YunelySR/Yunely_Sanchez_Electiva_2025_C1/Tema 5 - Diseño PCB/Clase 10 - Yunely Sánchez Ruiz.pdf

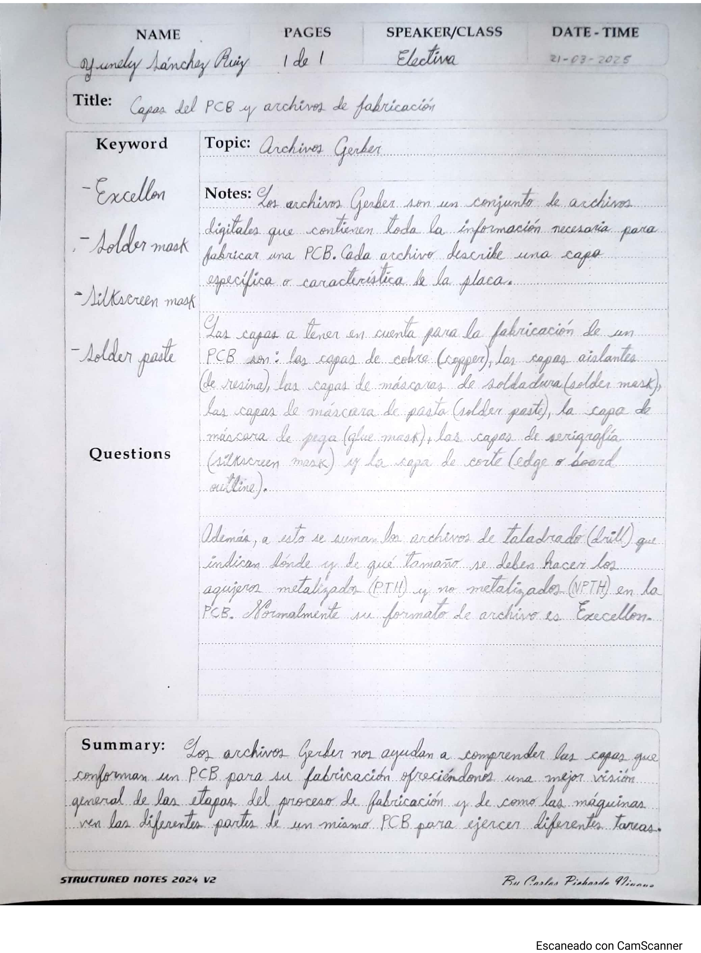
[picture p3: page 1]
