YunelySR/Yunely_Sanchez_Electiva_2025_C1/Tema 1 - Introducción al diseño mecatrónico/Clase 1.2 - Yunely Sánchez Ruiz.pdf

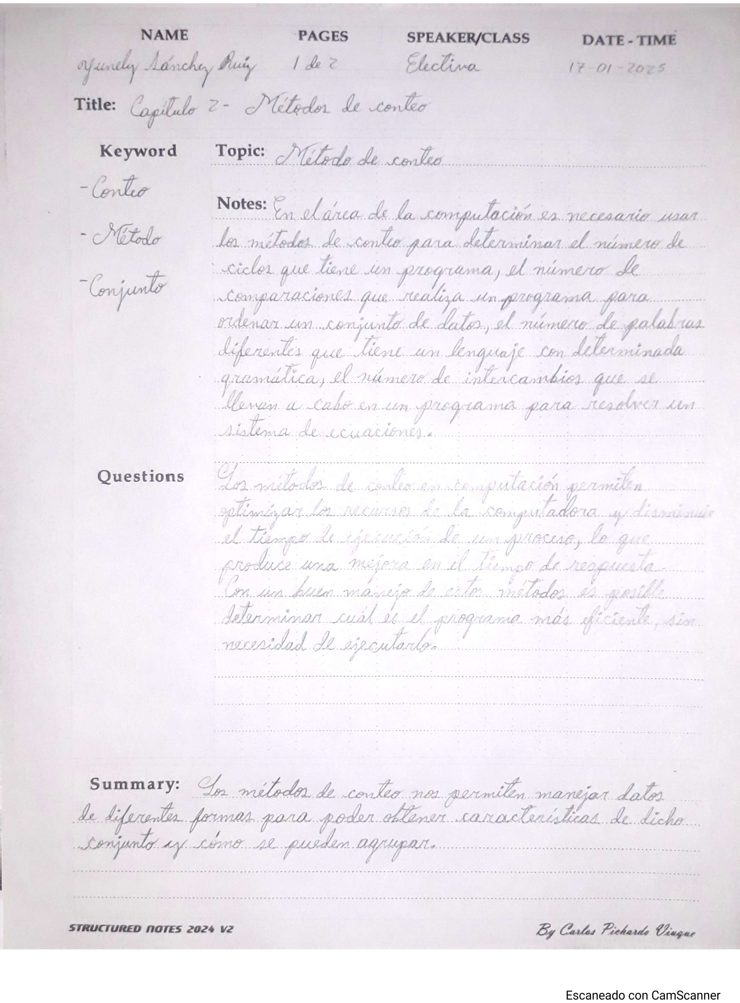
[picture p4: page 1]
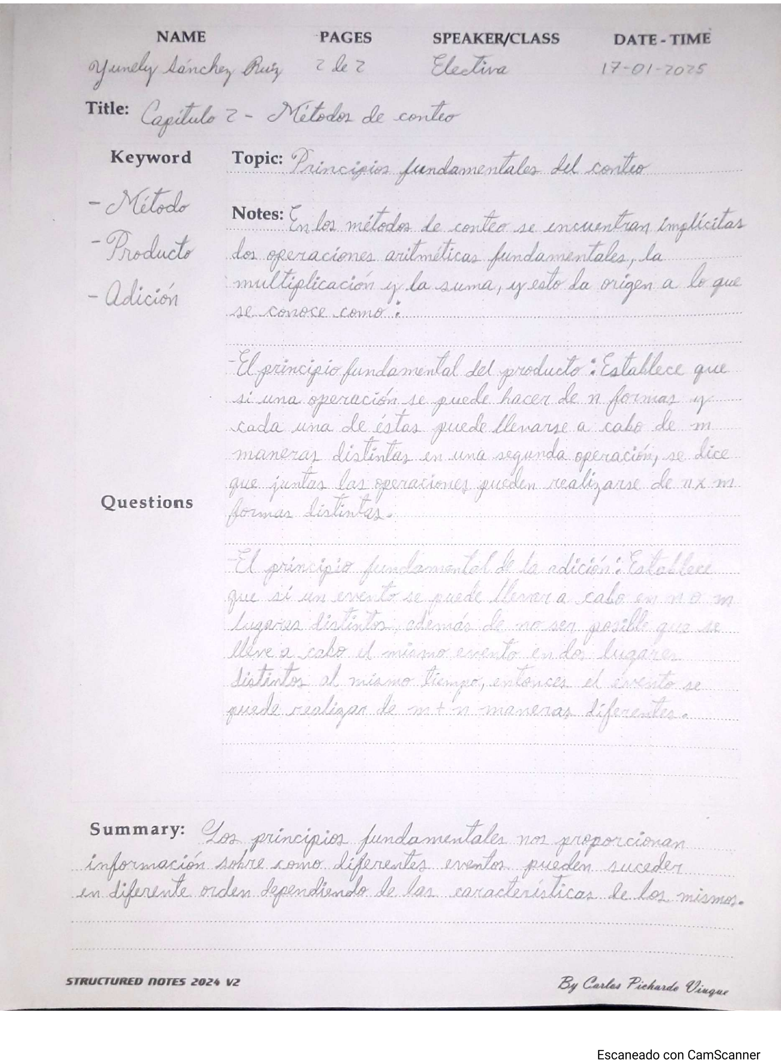
[picture p5: page 2]
