YunelySR/Yunely_Sanchez_Electiva_2025_C1/Tema 3 - Ingeniería de requisitos/Clase 5 - Yunely Sánchez Ruiz.pdf

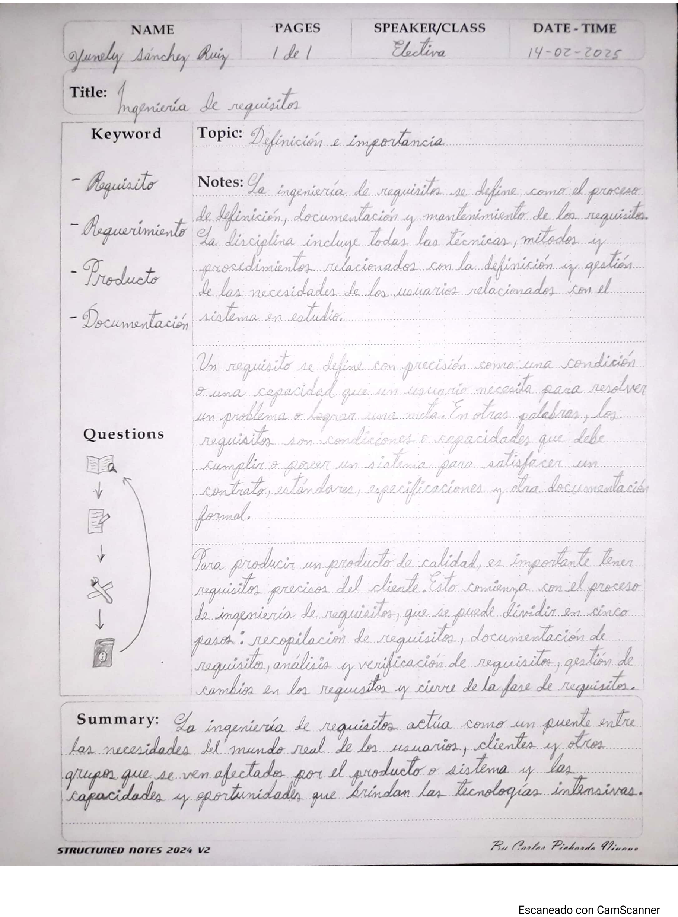
[picture p6: page 1]
