YunelySR/Yunely_Sanchez_Electiva_2025_C1/Librería de componentes.xlsx

Sheet: Resistencias
Número de parte | Valor (Ω) | Tolerancia (%) | Potencia (W) | Coeficiente de tempratura (PPM/°C) | Fabricante | Agregado
TNPW121010R0FEEA | 10 | 1 | 0.5 | 25 | Vishay | 1
TNPW1210100RFEEA | 100 | 1 | 0.5 | 25 | Vishay | 1
TNPW1206120RFEEA | 120 | 1 | 0.52 | 25 | Vishay | 1
TNPW1206220RFEEA | 220 | 1 | 0.52 | 25 | Vishay | 1
TNPW1206330RFEEA | 330 | 1 | 0.52 | 25 | Vishay | 1
TNPW1206470RFEEA | 470 | 1 | 0.52 | 25 | Vishay | 1
TNPW1206510RBEEA | 510 | 0.1 | 0.52 | 25 | Vishay | 1
TNPW1206560RFEEA | 560 | 1 | 0.52 | 25 | Vishay | 1
TNPW1206680RFEEA | 680 | 1 | 0.52 | 25 | Vishay | 1
TNPW1206820RBYEA | 820 | 0.1 | 0.52 | 10 | Vishay | 1
TNPW12101K00FEEA | 1k | 1 | 0.5 | 25 | Vishay | 1
PCAN0805E1001FST3 | 1k | 1 | 1 | 25 | Vishay | 1
TNPW12101K20BYEA | 1.2k | 0.1 | 0.5 | 10 | Vishay | 1
TNPW12102K20DEEA | 2.2k | 0.5 | 0.5 | 25 | Vishay | 1
TNPW12103K30BYEA | 3.3k | 0.1 | 0.5 | 10 | Vishay | 1
TNPW12104K70BEEA | 4.7k | 0.1 | 0.5 | 25 | Vishay | 1
TNPW12065K10BXEA | 5.1k | 0.1 | 0.52 | 15 | Vishay | 1
TNPW12065K60BEEA | 5.6k | 0.1 | 0.52 | 25 | Vishay | 1
TNPW12106K80BEEA | 6.8k | 0.1 | 0.5 | 25 | Vishay | 1
TNPW12068K20BEEA | 8.2k | 0.1 | 0.52 | 25 | Vishay | 1
TNPW121010K0DEEA | 10k | 0.5 | 0.5 | 25 | Vishay | 1
PHPA1206E1002BST1 | 10k | 0.1 | 1 | 25 | Vishay | 1
TNPW121012K0BEEA | 12k | 0.1 | 0.5 | 25 | Vishay | 1
TNPW120622K0BYEN | 22k | 0.1 | 0.52 | 10 | Vishay | 1
TNPW120633K0BYEN | 33k | 0.1 | 0.52 | 10 | Vishay | 1
MCA1206ME4702BP100 | 47k | 0.1 | 0.52 | 15 | Vishay | 1
TNPW120651K0DEEA | 51k | 0.1 | 0.52 | 25 | Vishay | 1
TNPW120656K0BEEA | 56k | 0.1 | 0.52 | 25 | Vishay | 1
TNPW120668K0BEEA | 68k | 0.1 | 0.52 | 25 | Vishay | 1
TNPW120682K0DEEA | 82k | 0.5 | 0.52 | 25 | Vishay | 1
TNPW1206100KBXEA | 100k | 0.1 | 0.52 | 15 | Vishay | 1
P-2512Y1003DSTS | 100k | 0.5 | 1 | 10 | Vishay | 1
TNPW1206120KBXEN | 120k | 0.1 | 0.52 | 15 | Vishay | 1
TNPW1206220KBEEA | 220k | 0.1 | 0.52 | 25 | Vishay | 1
TNPW1206330KDEEA | 330k | 0.5 | 0.52 | 25 | Vishay | 1
TNPW1206470KDEEA | 470k | 0.5 | 0.52 | 25 | Vishay | 1
TNPW1206510KDEEA | 510k | 0.5 | 0.52 | 25 | Vishay | 1
TNPW1206560KBEEA | 560k | 0.1 | 0.52 | 25 | Vishay | 1
TNPW1206680KBEEA | 680k | 0.1 | 0.52 | 25 | Vishay | 1
MCA1206MD8203DP500 | 820k | 0.5 | 0.52 | 25 | Vishay | 1
TNPW12101M00DEEA | 1M | 0.5 | 0.5 | 25 | Vishay | 1

Sheet: Capacitores
Número de parte | Valor (F) | Tolerancia (%) | Voltaje (v) | Tipo de voltaje | Vida útil (horas) | Tipo | Fabricante | Agregado
C0402C508B5GACAUTO | 0.5p | 20 | 50 | DC | - | Cerámico - Automtive MLCC | KEMET | 1
C0603C109B5GACAUTO | 1p | 10 | 50 | DC | - | Cerámico - Automtive MLCC | KEMET | 1
C0603C229B5GACAUTO | 2.2p | 5 | 50 | DC | - | Cerámico - Automtive MLCC | KEMET | 1
C0603C339B5GACAUTO | 3.3p | 3 | 50 | DC | - | Cerámico - Automtive MLCC | KEMET | 1
C0402C479B5GACAUTO | 4.7p | 2 | 50 | DC | - | Cerámico - Automtive MLCC | KEMET | 1
C0402C569B5GACAUTO | 5.6p | 2 | 50 | DC | - | Cerámico - Automtive MLCC | KEMET | 1
C0603C689B5GACAUTO | 6.8p | 2 | 50 | DC | - | Cerámico - Automtive MLCC | KEMET | 1
C0603C759C5GACAUTO | 7.5p | 3 | 50 | DC | - | Cerámico - Automtive MLCC | KEMET | 1
C0603C829C5GACAUTO | 8.2p | 3 | 50 | DC | - | Cerámico - Automtive MLCC | KEMET | 1
C0603C100F5GACAUTO | 10p | 1 | 50 | DC | - | Cerámico - Automtive MLCC | KEMET | 1
C0603C220F5GACAUTO | 22p | 1 | 50 | DC | - | Cerámico - Automtive MLCC | KEMET | 1
C0603C330F5GACAUTO | 33p | 1 | 50 | DC | - | Cerámico - Automtive MLCC | KEMET | 1
C0603C470F5GACAUTO | 47p | 1 | 50 | DC | - | Cerámico - Automtive MLCC | KEMET | 1
C0603C560F5GACAUTO | 56p | 1 | 50 | DC | - | Cerámico - Automtive MLCC | KEMET | 1
C0603C680F5GACAUTO | 68p | 1 | 50 | DC | - | Cerámico - Automtive MLCC | KEMET | 1
C0603C750J5GACAUTO | 75p | 5 | 50 | DC | - | Cerámico - Automtive MLCC | KEMET | 1
C0402C101G5GACAUTO | 100p | 2 | 50 | DC | - | Cerámico - Automtive MLCC | KEMET | 1
C0603C221F5GACAUTO | 220p | 1 | 50 | DC | - | Cerámico - Automtive MLCC | KEMET | 1
C0603C331F5GACAUTO | 330p | 1 | 50 | DC | - | Cerámico - Automtive MLCC | KEMET | 1
C0603C471F5GACAUTO | 470p | 1 | 50 | DC | - | Cerámico - Automtive MLCC | KEMET | 1
C0603C561J5GACAUTO | 560p | 5 | 50 | DC | - | Cerámico - Automtive MLCC | KEMET | 1
C0603C681F5GACAUTO | 680p | 1 | 50 | DC | - | Cerámico - Automtive MLCC | KEMET | 1
C0603C751J5GACAUTO | 750p | 5 | 50 | DC | - | Cerámico - Automtive MLCC | KEMET | 1
C0603C821F5GACAUTO | 820p | 1 | 50 | DC | - | Cerámico - Automtive MLCC | KEMET | 1
C0603C102F5GACAUTO | 1n | 1 | 50 | DC | - | Cerámico - Automtive MLCC | KEMET | 1
C0603C222F5GACAUTO | 2.2n | 1 | 50 | DC | - | Cerámico - Automtive MLCC | KEMET | 1
C0603C332F5GACAUTO | 3.3n | 1 | 50 | DC | - | Cerámico - Automtive MLCC | KEMET | 1
C0603C472F5GACAUTO | 4.7n | 1 | 50 | DC | - | Cerámico - Automtive MLCC | KEMET | 1
C0603C562J5GACAUTO | 5.6n | 5 | 50 | DC | - | Cerámico - Automtive MLCC | KEMET | 1
C0603C682J5GACAUTO | 6.8n | 5 | 50 | DC | - | Cerámico - Automtive MLCC | KEMET | 1
C0805C752J2GACAUTO | 7.5n | 5 | 200 | DC | - | Cerámico - Automtive MLCC | KEMET | 1
C0805C822J1GACAUTO | 8.2n | 5 | 100 | DC | - | Cerámico - Automtive MLCC | KEMET | 1
C0603C103J5RECAUTO | 10n | 5 | 50 | DC | - | Cerámico - Automtive MLCC | KEMET | 1
C0603C223J5RECAUTO | 22n | 5 | 50 | DC | - | Cerámico - Automtive MLCC | KEMET | 1
C0603C333J5RECAUTO | 33n | 5 | 50 | DC | - | Cerámico - Automtive MLCC | KEMET | 1
C0603C473J5RECAUTO | 47n | 5 | 50 | DC | - | Cerámico - Automtive MLCC | KEMET | 1
C1206C563G5GACAUTO | 56n | 2 | 50 | DC | - | Cerámico - Automtive MLCC | KEMET | 1
C0603C683J5RECAUTO | 68n | 5 | 50 | DC | - | Cerámico - Automtive MLCC | KEMET | 1
C1210C823J5GACAUTO | 82n | 5 | 50 | DC | - | Cerámico - Automtive MLCC | KEMET | 1
C0603C104J5RECAUTO | 100n | 5 | 50 | DC | - | Cerámico - Automtive MLCC | KEMET | 1
C0805C224J5RECAUTO | 220n | 5 | 50 | DC | - | Cerámico - Automtive MLCC | KEMET | 1
C0805C334J5RECAUTO | 330n | 5 | 50 | DC | - | Cerámico - Automtive MLCC | KEMET | 1
C0805C474J5RECAUTO | 470n | 5 | 50 | DC | - | Cerámico - Automtive MLCC | KEMET | 1
C0805C684J5RECAUTO | 680n | 5 | 50 | DC | - | Cerámico - Automtive MLCC | KEMET | 1
C0805X105J5RACAUTO | 1u | 5 | 50 | DC | - | Cerámico - Automtive MLCC | KEMET | 1
EXV105M050A9BAA | 1u | 20 | 50 | DC | 3000 | Electrolítico de aluminio | KEMET | 1
EXV225M050A9BAA | 2.2u | 20 | 50 | DC | 3000 | Electrolítico de aluminio | KEMET | 1
EXV335M050A9BAA | 3.3u | 20 | 50 | DC | 3000 | Electrolítico de aluminio | KEMET | 1
EXV475M050S9DAA | 4.7u | 20 | 50 | DC | 3000 | Electrolítico de aluminio | KEMET | 1
EDH685M050S9DAA | 6.8u | 20 | 50 | DC | 2000 | Electrolítico de aluminio | KEMET | 1
EXV106M050S9GAA | 10u | 20 | 50 | DC | 3000 | Electrolítico de aluminio | KEMET | 1
EXV226M050S9HAA | 22u | 20 | 50 | DC | 3000 | Electrolítico de aluminio | KEMET | 1
EXV336M050S9MAA | 33u | 20 | 50 | DC | 5000 | Electrolítico de aluminio | KEMET | 1
EXV476M050S9PAA | 47u | 20 | 50 | DC | 5000 | Electrolítico de aluminio | KEMET | 1
EXV686M050S9PAA | 68u | 20 | 50 | DC | 5000 | Electrolítico de aluminio | KEMET | 1
EXV107M050S9PAA | 100u | 20 | 50 | DC | 5000 | Electrolítico de aluminio | KEMET | 1
EXV227M050S9PAA | 220u | 20 | 50 | DC | 5000 | Electrolítico de aluminio | KEMET | 1
EXV337M050S9RAA | 330u | 20 | 50 | DC | 5000 | Electrolítico de aluminio | KEMET | 1
EDH477M063S9TAA | 470u | 20 | 63 | DC | 2000 | Electrolítico de aluminio | KEMET | 1
PES228MKP3750QE4 | 750u | 20 | 63 | DC | 6300 | Electrolítico de aluminio | KEMET | 1
EDH108M050S9TAA | 1m | 20 | 50 | DC | 2000 | Electrolítico de aluminio | KEMET | 1
PES227KKP4220ME4 | 2.2m | 20 | 40 | DC | 6300 | Electrolítico de aluminio | KEMET | 0.5
PEV227HKL4320ME4 | 3.2m | 20 | 25 | DC | 6300 | Electrolítico de aluminio | KEMET | 1
PES227HKP4460ME4 | 4.6m | 20 | 25 | DC | 6300 | Electrolítico de aluminio | KEMET | 0.5

Sheet: Bobinas
Número de parte | Valor (H) | Tolerancia (%) | Corriente (A) | Tipo | Fabricante | Agregado
MLG1005S1N0BTD25 | 1n | 10 | 1 | Inductor RF multicapa | TDK | 1
MHQ1005P2N2BTD25 | 2.2n | 5 | 1 | Inductor RF multicapa | TDK | 1
MHQ1005P3N3BTD25 | 3.3n | 3 | 900m | Inductor RF multicapa | TDK | 1
MHQ1005P4N7BTD25 | 4.7n | 2 | 800m | Inductor RF multicapa | TDK | 1
MHQ1005P5N6BTD25 | 5.6n | 2 | 800m | Inductor RF multicapa | TDK | 1
MHQ1005P6N8GTD25 | 6.8n | 2 | 700m | Inductor RF multicapa | TDK | 1
MHQ1005P7N5GTD25 | 7.5n | 2 | 600m | Inductor RF multicapa | TDK | 1
MHQ1005P8N2GTD25 | 8.2 | 2 | 550m | Inductor RF multicapa | TDK | 1
MHQ1005P10NGTD25 | 10n | 2 | 500m | Inductor RF multicapa | TDK | 1
MLG1005S22NHTD25 | 22n | 3 | 350m | Inductor RF multicapa | TDK | 1
MLG1005S33NHTD25 | 33n | 3 | 300m | Inductor RF multicapa | TDK | 1
MLF2012D47NMTD25 | 47n | 20 | 300m | Inductor RF multicapa | TDK | 1
MLG1005S56NHTD25 | 56n | 3 | 200m | Inductor RF multicapa | TDK | 1
MLF2012D68NMTD25 | 68n | 20 | 300m | Inductor RF multicapa | TDK | 1
MLG1005S75NHTD25 | 75n | 3 | 200m | Inductor RF multicapa | TDK | 1
MLF2012D82NMTD25 | 82n | 20 | 300m | Inductor RF multicapa | TDK | 1
MLF2012DR10JTD25 | 100n | 5 | 300m | Inductor RF multicapa | TDK | 1
MLF2012DR22JTD25 | 220n | 5 | 250m | Inductor RF multicapa | TDK | 1
MLF2012DR33JTD25 | 330n | 5 | 250m | Inductor RF multicapa | TDK | 1
MLF2012DR47JTD25 | 470n | 5 | 200m | Inductor RF multicapa | TDK | 1
MLJ1608WGCR56NTD25 | 560n | 30 | 500m | Inductor RF multicapa | TDK | 1
MLF2012DR68JTD25 | 680n | 5 | 150m | Inductor RF multicapa | TDK | 1
MLF2012DR82JTD25 | 820n | 5 | 150m | Inductor RF multicapa | TDK | 1
KLZ2012AHR1R0WTD25 | 1u | 20 | 800m | Inductor RF multicapa | TDK | 1
SPM4030T-1R0M-HZ | 1u | 20 | 8 | Inductor de potencia | TDK | 1
KLZ2012AHR2R2WTD25 | 2.2u | 20 | 600m | Inductor RF multicapa | TDK | 1
SPM6530T-2R2M-HZ | 2.2u | 20 | 8.4 | Inductor de potencia | TDK | 1
KLZ2012MHR3R3HTD25 | 3.3u | 20 | 500m | Inductor RF multicapa | TDK | 1
SPM7054VT-3R3M-D | 3.3u | 20 | 9.5 | Inductor de potencia | TDK | 1
KLZ2012MHR4R7HTD25 | 4.7u | 20 | 400m | Inductor RF multicapa | TDK | 1
SPM6550T-4R7M-HZ | 4.7u | 20 | 8.2 | Inductor de potencia | TDK | 1
MLF1608E5R6JTD25 | 5.6u | 5 | 15m | Inductor RF multicapa | TDK | 1
SLF12575T-5R6N6R3-H | 5.6u | 30 | 6.3 | Inductor de potencia | TDK | 1
MLF1608E6R8JTD25 | 6.8u | 5 | 15m | Inductor RF multicapa | TDK | 1
SPM7054VT-6R8M-D | 6.8 | 20 | 6.8 | Inductor de potencia | TDK | 1
MLF1608E8R2JTD25 | 8.2u | 5 | 10m | Inductor RF multicapa | TDK | 1
B82442T1822K000 | 8.2u | 10 | 1.51 | Inductor de potencia | TDK | 1
KLZ2012MHR100HTD25 | 10u | 20 | 300m | Inductor RF multicapa | TDK | 1
SPM12565VT-100M-D | 10u | 20 | 9 | Inductor de potencia | TDK | 1
KLZ2012PHR220WTD25 | 22u | 20 | 220m | Inductor RF multicapa | TDK | 1
SPM12565VT-220M-D | 22u | 20 | 6.9 | Inductor de potencia | TDK | 1
MLF2012C330KTD25 | 33u | 10 | 5m | Inductor RF multicapa | TDK | 1
SPM10065VT-330M-D | 33u | 20 | 4.9 | Inductor de potencia | TDK | 1
KLZ2012MHR470WTD25 | 47u | 20 | 170m | Inductor RF multicapa | TDK | 1
SPM10065VT-470M-D | 47u | 20 | 4 | Inductor de potencia | TDK | 1
MLF2012K560KTD25 | 56u | 10 | 4m | Inductor RF multicapa | TDK | 1
B82442T1563K000 | 56u | 10 | 600m | Inductor de potencia | TDK | 1
MLF2012C680KTD25 | 68u | 10 | 2m | Inductor RF multicapa | TDK | 1
SPM10065VT-680M-D | 68u | 20 | 3.4 | Inductor de potencia | TDK | 1
MLF2012C820KTD25 | 82u | 10 | 2m | Inductor RF multicapa | TDK | 1
B82442T1823K000 | 82u | 10 | 540m | Inductor de potencia | TDK | 1
KLZ2012NHR101LTD25 | 100u | 20 | 140m | Inductor RF multicapa | TDK | 1
SPM7054VT-101M-D | 100u | 20 | 1.8 | Inductor de potencia | TDK | 1
CLF7045NIT-221M-D | 220u | 20 | 710m | Inductor de potencia | TDK | 1
CLF7045NIT-331M-D | 330u | 20 | 600m | Inductor de potencia | TDK | 1
CLF7045NIT-471M-D | 470u | 20 | 500m | Inductor de potencia | TDK | 1
B82442T1564K000 | 560u | 10 | 220m | Inductor de potencia | TDK | 1
B82464G4684M000 | 680u | 20 | 420m | Inductor de potencia | TDK | 1
B82442T1824K000 | 820u | 10 | 170m | Inductor de potencia | TDK | 1
B82464G4105M000 | 1m | 20 | 340m | Inductor de potencia | TDK | 1
B82442T1225K000 | 2.2m | 10 | 100m | Inductor de potencia | TDK | 1
B82442T1335K000 | 3.3m | 10 | 85m | Inductor de potencia | TDK | 1
B82442T1475K000 | 4.7m | 10 | 73m | Inductor de potencia | TDK | 1
B82442T1565K000 | 5.6m | 10 | 66m | Inductor de potencia | TDK | 1
B82442T1685K000 | 6.8m | 10 | 65m | Inductor de potencia | TDK | 1
B82442T1825K000 | 8.2m | 10 | 54m | Inductor de potencia | TDK | 1
B82442T1106K000 | 10m | 10 | 46m | Inductor de potencia | TDK | 1

Sheet: Transistores
Número de parte | Tecnología | Polaridad | Vgs-th (v) | Id (A) | Potencia (W) | Fabricante | Agregado
NVR5198NLT1G | MOSFET | Canal N | 1.5 | 2.2 | 1.5 | ONSEMI | 1
SVD5867NLT4G | MOSFET | Canal N | 1.5 | 22 | 43 | ONSEMI | 1
NVD5805NT4G-VF01 | MOSFET | Canal N | 1.5 | 51 | 47 | ONSEMI | 1
NCV8406BDTRKG | MOSFET | Canal N | 2 | 7 | 1.31 | ONSEMI | 1
NVMFS6H864NLT1G | MOSFET | Canal N | 2 | 22 | 33 | ONSEMI | 1
FDWS86368-F085 | MOSFET | Canal N | 2 | 80 | 214 | ONSEMI | 1
NVR5198NLT3G | MOSFET | Canal N | 2.5 | 2.2 | 1.5 | ONSEMI | 1
NVMFS5C468NT1G | MOSFET | Canal N | 2.5 | 35 | 28 | ONSEMI | 1
NVMFS5C456NWFT1G | MOSFET | Canal N | 2.5 | 80 | 55 | ONSEMI | 1
NVB082N65S3F | MOSFET | Canal N | 3 | 40 | 313 | ONSEMI | 1
NVTFS010N10MCLTAG | MOSFET | Canal N | 3 | 57.8 | 3.2 | ONSEMI | 1
NVMFS3D6N10MCLT1G | MOSFET | Canal N | 3 | 132 | 139 | ONSEMI | 1
NVMYS011N04CTWG | MOSFET | Canal N | 3.5 | 35 | 28 | ONSEMI | 1
NVMYS8D0N04CTWG | MOSFET | Canal N | 3.5 | 49 | 38 | ONSEMI | 1
NVMFS5C456NT1G | MOSFET | Canal N | 3.5 | 80 | 55 | ONSEMI | 1
NVTFS6H854NLTAG | MOSFET | Canal N | 4 | 44 | 68 | ONSEMI | 1
NVMFS6H836NLT1G | MOSFET | Canal N | 4 | 74 | 89 | ONSEMI | 1
NVMFS5C628NWFT1G | MOSFET | Canal N | 4 | 150 | 110 | ONSEMI | 1

Sheet: OPAMPs
Número de parte | Número de canales | GBP (Hz) | SR (V/us) | Vos (v) | Ib (A) | CMRR (dB) | Vdd Min (v) | Shutdown | Fabricante | Agregado
LTC2066HS5#TRMPBF | 1 | 100k | 17.5m | 1u | 5p | 134 | 1.7 | Sí | Analog Devices | 1
MAX4091AUK+T | 1 | 500k | 200m | 1.4m | 180n | 71 | 2.7 | No | Analog Devices | 1
AD548JRZ | 1 | 1M | 1.8 | 750u | 10p | 90 | 9 | No | Analog Devices | 1
AD8565AKSZ-REEL7 | 1 | 5M | 6 | 2m | 80n | 95 | 4.5 | No | Analog Devices | 1
MAX40075AUT/V+T | 1 | 10M | 10 | 30u | 1p | 109 | 2.7 | Sí | Analog Devices | 1
AD8031ARZ-REEL | 1 | 50M | 32 | 1m | 2u | 90 | 2.7 | No | Analog Devices | 1
MAX4105EUK+T | 1 | 100M | 1.4k | 1m | 70u | 80 | 7 | No | Analog Devices | 1
OP281GSZ | 2 | 105k | 27m | 1.5m | 10n | 65 | 2.7 | No | Analog Devices | 1
MAX4402AKA/V+T | 2 | 800k | 1 | 1m | 100f | 84 | 2.5 | No | Analog Devices | 1
AD648KRZ | 2 | 1M | 1.8 | 750u | 15p | 76 | 9 | No | Analog Devices | 1
AD8566ARMZ-REEL | 2 | 5M | 6 | 2m | 80n | 95 | 4.5 | No | Analog Devices | 1
MAX40077AUA+T | 2 | 10M | 10 | 30u | 260p | 90 | 2.7 | Sí | Analog Devices | 1
AD8032ARZ-REEL7 | 2 | 50M | 32 | 1m | 12u | 90 | 2.7 | No | Analog Devices | 1
AD8062ARZ-R7 | 2 | 90M | 650 | 1m | 9u | 80 | 2.7 | No | Analog Devices | 1
ADA4891-3ARZ | 3 | 105M | 170 | 2.5m | 50p | 88 | 2.7 | No | Analog Devices | 1
ADA4891-3ARZ-R7 | 3 | 105M | 210 | 2..5m | 50p | 88 | 2.7 | No | Analog Devices | 1
OP481GSZ | 4 | 105k | 28m | 100u | 10n | 65 | 2.7 | No | Analog Devices | 1
OP496GSZ | 4 | 450k | 300m | 300u | 50n | 65 | 3 | No | Analog Devices | 1
AD8544WARZ-R7 | 4 | 1M | 920m | 1m | 60p | 45 | 2.7 | No | Analog Devices | 1
AD8567ARUZ | 4 | 5M | 6 | 2m | 80n | 95 | 4.5 | No | Analog Devices | 1
MAX40078AUD+ | 4 | 10M | 10 | 30u | 260p | 90 | 2.7 | Sí | Analog Devices | 1
AD8040ARUZ | 4 | 45M | 62 | 1.6m | 1.3u | 80 | 2.7 | No | Analog Devices | 1
ADA4891-4ARZ | 4 | 105M | 170 | 2.5m | 50p | 88 | 2.7 | No | Analog Devices | 1

Sheet: LEDs
Número de parte | Tipo | Color | If (A) | Vf (v) | Fabricante | Agregado
LS L29K-G1J2-1 | Unicolor | Rojo | 2m | 2.2 | ams OSRAM | 1
KB DELPS2.DI-QGRI-2J8L-U515 | Unicolor | Azul | 2m | 2.7 | ams OSRAM | 1
LG T67K-H2K2-24 | Unicolor | Verde | 2m | 1.9 | ams OSRAM | 0.5
LY T67K-J2M1-26 | Unicolor | Amarillo | 20m | 2.2 | ams OSRAM | 0.5
KW DELPS2.RA-QISI-FK2NM2-U515 | Unicolor | Blanco | 2m | 2.7 | ams OSRAM | 1
LA M676-K1M1-24-Z | Unicolor | Ámbar | 2m | 1.8 | ams OSRAM | 0.5
LO M67K-L1M2-24-0-2-R18-Z | Unicolor | Naranja | 2m | 1.8 | ams OSRAM | 0.5
LSG T67K-JL-1+HK-1 | Bicolor | Rojo-Verde | 2m | 1.8 | ams OSRAM | 1
LSY T676-P2R1-1-0+Q2S1-35 | Bicolor | Rojo-Amarillo | 30m | 2.4 | ams OSRAM | 1
LYG T67K-JL-1+HK-1 | Bicolor | Amarillo-Verde | 2m | 1.9 | ams OSRAM | 1
SFH 7018A | Tricolor | Rojo-Verde-Infrarojo | 250m | 2.7 | ams OSRAM | 1
KRTBLSLPS1.32-VUVY-EQ+BTBV-D8+TXUV-L1-B | Multicolor | RGB | 20m | 2.8 | ams OSRAM | 0.5
LTRBR37G-4R4S-0125-0 | RGB | RGB | 2m | 2.8 | ams OSRAM | 1
LRTB R48G | RGB | RGB | 10m | 2.7 | ams OSRAM | 1
KRTBLFLM71.32-TZUV-GQ+VTVX-FM+RYSX-QW-LB | RGB | RGB | 15m | 3 | ams OSRAM | 0.5
LRTBR98G-R5T-1+S7T7-35+PQ-25 | RGB | RGB | 20m | 3.2 | ams OSRAM | 1
SFH 4243-Q1R2 | IR | IR | 70m | 1.6 | ams OSRAM | 1
SFH 4249-UV | IR | IR | 100m | 1.5 | ams OSRAM | 1

Sheet: Varistores
Número de parte | Régimen de voltaje DC (v) | Régimen de voltaje AC (v) | Voltaje nominal (v) | Voltaje de clamping (v) | Fabricante | Agregado
V8ZA2P | 5 | 4 | 6 | 20 | Littelfuse | 1
V9MLA0603NH | 9 | 6.5 | 11 | 25.5 | Littelfuse | 1
V12MLA0805LNHAUTO | 12 | 9 | 14 | 29 | Littelfuse | 1
V22MA1A | 15 | 10 | 22 | 55 | Littelfuse | 0.5
V24AUMLA2220H | 24 | - | 39 | 60 | Littelfuse | 1
V27MA1A | 19 | 13 | 21 | 67 | Littelfuse | 0.5
V39ZA1P | 31 | 25 | 35 | 79 | Littelfuse | 0.5
V100ZA15P | 81 | 60 | 90 | 175 | Littelfuse | 0.5
V130LA20BP | 175 | 130 | 190 | 325 | Littelfuse | 0.5
V430MA3A | 349 | 253 | 365 | 740 | Littelfuse | 0.5
V20E385P | 505 | 385 | 558 | 1025 | Littelfuse | 1
V20E440P | 585 | 440 | 643 | 1180 | Littelfuse | 0.5

Sheet: Diodos TVS
Número de parte | Número de canales | Voltaje de funcionamiento inverso (v) | Voltaje de clamping (v) | Polaridad | Fabricante | Agregado
SMF3.3 | 1 | 3.3 | 6.8 | Unidireccional | Littelfuse | 1
SP3031-01ETG | 1 | 5 | 7.5 | Unidireccional | Littelfuse | 1
SMF4L9.0A | 1 | 9 | 15.4 | Unidireccional | Littelfuse | 1
SACB10 | 1 | 10 | 16.3 | Unidireccional | Littelfuse | 1
TPSMB12A-VR | 1 | 12 | 19.9 | Unidireccional | Littelfuse | 1
SPHV15-01ETG | 1 | 15 | 22 | Unidireccional | Littelfuse | 0.5
SMA6J24A | 1 | 24 | 38.9 | Unidireccional | Littelfuse | 1
SP3401-02UTG | 2 | 3.3 | 9 | Unidireccional | Littelfuse | 1
SM05-02HTG | 2 | 5 | 13 | Unidireccional | Littelfuse | 1
SP4010-02HTG | 2 | 10 | 43 | Unidireccional | Littelfuse | 0.5
SM12-02HTG | 2 | 12 | 22.5 | Unidireccional | Littelfuse | 1
SM15-02HTG | 2 | 15 | 30 | Unidireccional | Littelfuse | 1
SM24-02HTG | 2 | 24 | 42 | Unidireccional | Littelfuse | 0.5
SP3420-04UTG | 4 | 3.3 | 6 | Unidireccional | Littelfuse | 1
SP3019-04HTG | 4 | 5 | 11.5 | Unidireccional | Littelfuse | 1
SP4065-08ATG | 8 | 3.3 | 13.5 | Unidireccional | Littelfuse | 1
SP7538PUTG | 8 | 5 | 7 | Unidireccional | Littelfuse | 0.5
SC1533-01FTG | 1 | 3.3 | 6.8 | Bidireccional | Littelfuse | 1
SP4337-01WTG | 1 | 5 | 7 | Bidireccional | Littelfuse | 1
SESD0201X1BN-0010-098 | 1 | 9 | 10 | Bidireccional | Littelfuse | 1
TPSMB12CA-VR | 1 | 12 | 19.9 | Bidireccional | Littelfuse | 1
PGB2010201KR-15NR | 1 | 15 | 20 | Bidireccional | Littelfuse | 1
SP4338-02WTG | 2 | 5 | 6 | Bidireccional | Littelfuse | 1
SP712-02HTG | 2 | 12 | 20 | Bidireccional | Littelfuse | 1
AQ15-02HTG | 2 | 15 | 30 | Bidireccional | Littelfuse | 1
AQ24-02HTG | 2 | 24 | 42 | Bidireccional | Littelfuse | 0.5
SP1015-04WTG | 4 | 5 | 12 | Bidireccional | Littelfuse | 1
SP1012-05WTG | 5 | 5 | 12.3 | Bidireccional | Littelfuse | 1

Sheet: No clasificados
SSSF021500 | Switch
B3SL-1022P | Botón
12401832E402A | Conector USB
WJ128V-5.0-6P | Screw terminal block
3296W-1-203LF | Potenciómetro
RLB1014-104KL | Bobina de poder
RVT1H470M0607 | Capacitor bulk
XT30UPB-M | Conector XT30
