YunelySR/Yunely_Sanchez_Electiva_2025_C1/Tema 2 - Selección de componentes/Clase 2 - Yunely Sánchez Ruiz.pdf

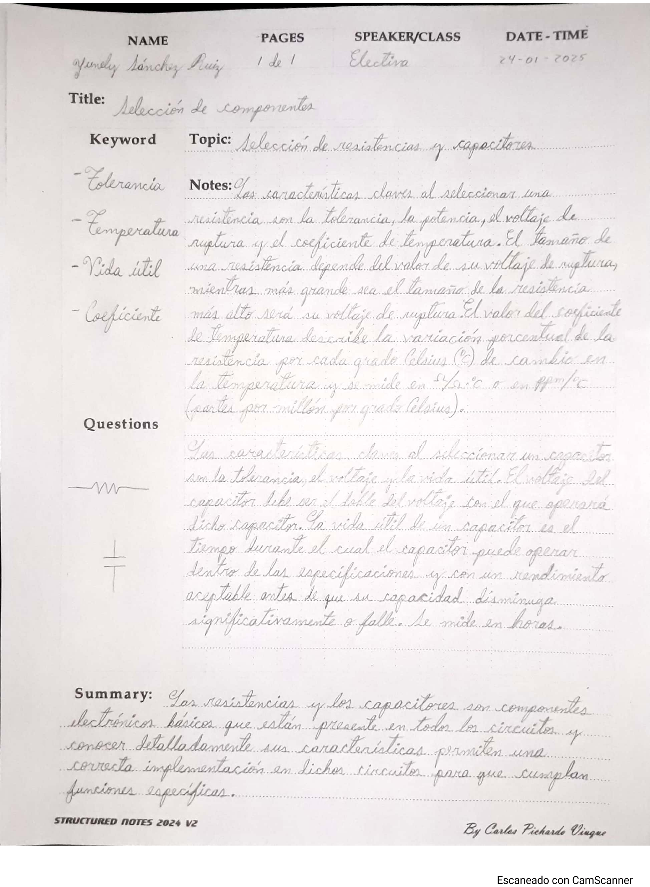
[picture p9: page 1]
