YunelySR/Yunely_Sanchez_Electiva_2025_C1/Tema 2 - Selección de componentes/Clase 3 - Yunely Sánchez Ruiz.pdf

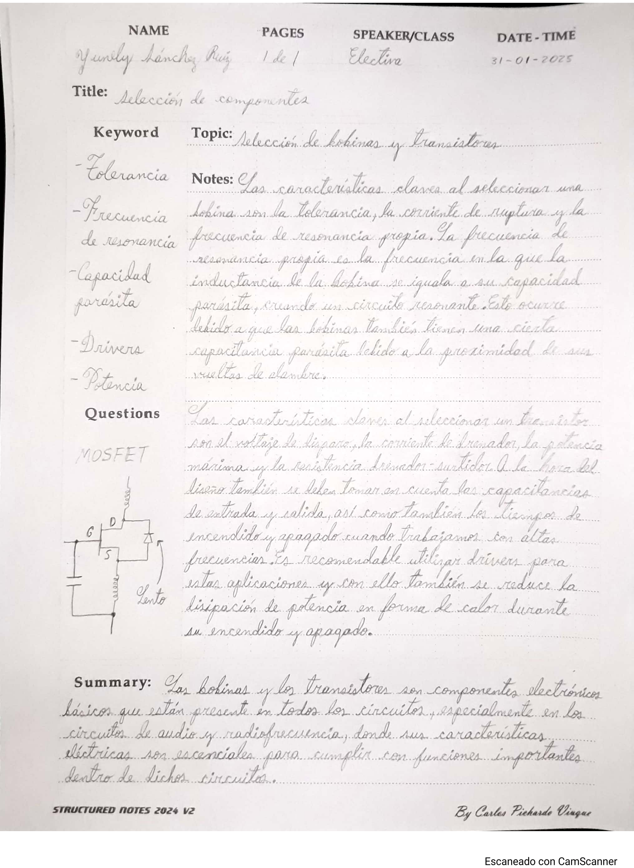
[picture p10: page 1]
