YunelySR/Yunely_Sanchez_Electiva_2025_C1/Tema 6 - Diseño mecánico/Tarea_3_Diseño_de_la_carcasa/Diseño en FreeCAD/Parte inferior.FCStd

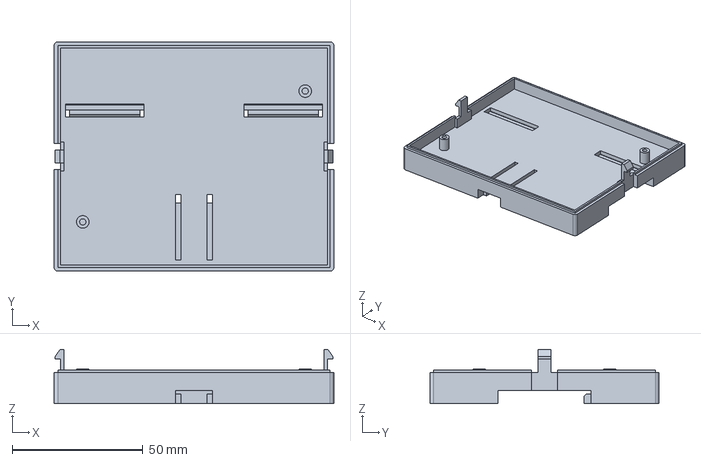
[picture p12: CAD file, 2025-04-21]
Tema 6 - Diseño mecánico/Tarea_3_Diseño_de_la_carcasa/Diseño en FreeCAD/Parte inferior.FCStd
107.0 x 87.7 x 20.8 mm
