YunelySR/Yunely_Sanchez_Electiva_2025_C1/(list of files, cad)

Other CAD files:
Tema 6 - Diseño mecánico/Tarea_3_Diseño_de_la_carcasa/Diseño en FreeCAD/Ensamble.FCStd
