YunelySR/Yunely_Sanchez_Electiva_2025_C1/Tema 4 - De requisitos a diseño mecatrónico/Tarea_2_Aislador_USB/Tarea_2_Aislador_USB.kicad_pcb

## KiCad design Tema 4 - De requisitos a diseño mecatrónico/Tarea_2_Aislador_USB/Tarea_2_Aislador_USB.kicad_pcb (2025-03-21)

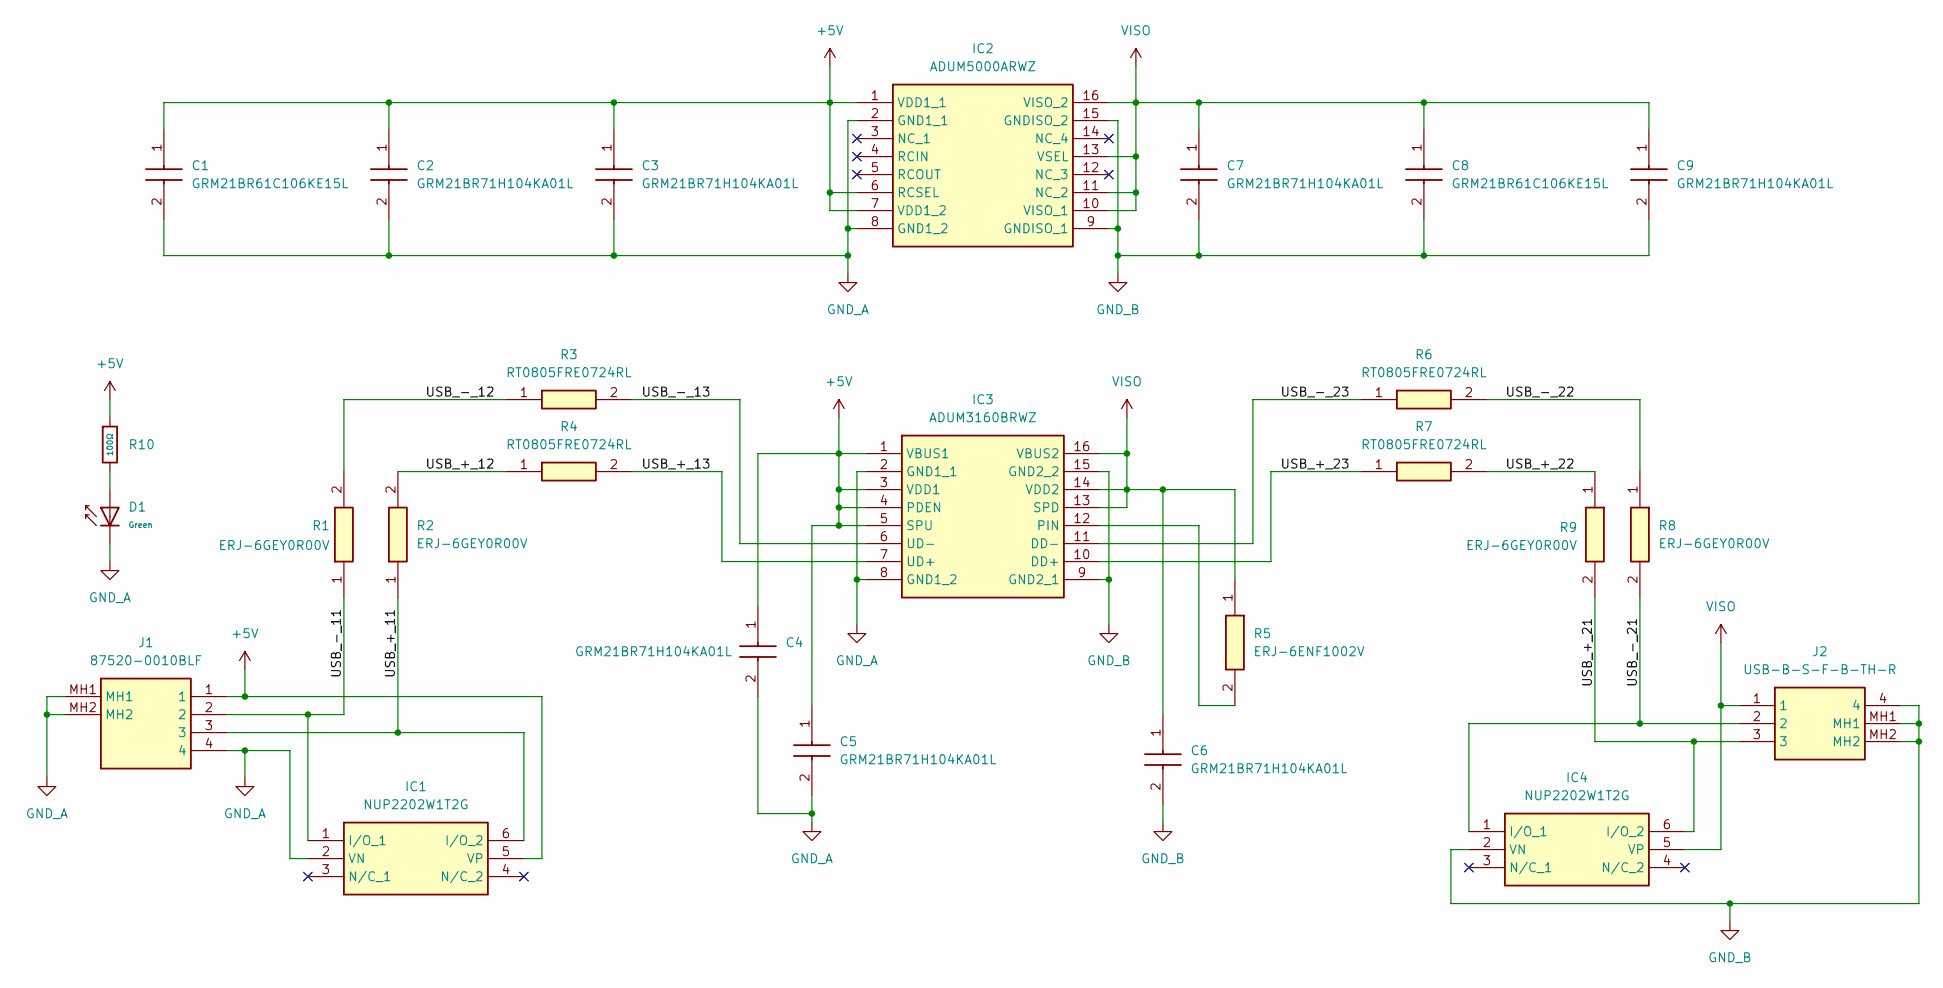
[picture p15: schematic Tarea_2_Aislador_USB.kicad_sch]

Parts:
C1, C8: GRM21BR61C106KE15L; CAPC2012X145N; Manufacturer_Part_Number GRM21BR61C106KE15L; Mouser Part Number 81-GRM21BR61C106KE15
C2, C3, C4, C5, C6, C7, C9: GRM21BR71H104KA01L; CAPC2012X145N; Manufacturer_Part_Number GRM21BR71H104KA01L; Mouser Part Number 81-GRM40X104K50L
D1: Green; D_0603; Part 19-217/GHC-YR1S2/6T; LCSC C2986059
IC1, IC4: NUP2202W1T2G; SOT65P210X110-6N; Manufacturer_Part_Number NUP2202W1T2G; Mouser Part Number 863-NUP2202W1T2G
IC2: ADUM5000ARWZ; SOIC127P1032X265-16N; Manufacturer_Part_Number ADUM5000ARWZ; Mouser Part Number 584-ADUM5000ARWZ
IC3: ADUM3160BRWZ; SOIC127P1032X265-16N; Manufacturer_Part_Number ADUM3160BRWZ; Mouser Part Number 584-ADUM3160BRWZ
J1: 87520-0010BLF; 875200010BLF; Manufacturer_Part_Number 87520-0010BLF
J2: USB-B-S-F-B-TH-R; USBBSFBTHR; Manufacturer_Part_Number USB-B-S-F-B-TH-R; Mouser Part Number 200-USBBSFBTHR
R1, R2, R8, R9: ERJ-6GEY0R00V; RESC2012X70N; Manufacturer_Part_Number ERJ-6GEY0R00V; Mouser Part Number 667-ERJ-6GEY0R00V
R3, R4, R6, R7: RT0805FRE0724RL; RESC2012X60N; Manufacturer_Part_Number RT0805FRE0724RL
R5: ERJ-6ENF1002V; ERJ6ENF1000V; Manufacturer_Part_Number ERJ-6ENF1002V; Mouser Part Number 667-ERJ-6ENF1002V
R10: 100Ω; R_0603; Overload Voltage (Max) 75V; Tolerance ±1%; Part 0603WAF1000T5E; LCSC C22775

Connections:
+5V: C1.1, C2.1, C3.1, C4.1, C5.1, IC1.5 (VP), IC2.1 (VDD1_1), IC2.6 (RCSEL), IC2.7 (VDD1_2), IC3.1 (VBUS1), IC3.3 (VDD1), IC3.4 (PDEN), IC3.5 (SPU), J1.1, R10.1
/USB_+_11: IC1.6 (I/O_2), J1.3, R2.1
/USB_+_12: R2.2, R4.1
/USB_+_13: IC3.7 (UD+), R4.2
/USB_+_21: IC4.6 (I/O_2), J2.3, R9.2
/USB_+_22: R7.2, R9.1
/USB_+_23: IC3.10 (DD+), R7.1
/USB_-_11: IC1.1 (I/O_1), J1.2, R1.1
/USB_-_12: R1.2, R3.1
/USB_-_13: IC3.6 (UD-), R3.2
/USB_-_21: IC4.1 (I/O_1), J2.2, R8.2
/USB_-_22: R6.2, R8.1
/USB_-_23: IC3.11 (DD-), R6.1
GND_A: C1.2, C2.2, C3.2, C4.2, C5.2, D1.1, IC1.2 (VN), IC2.2 (GND1_1), IC2.8 (GND1_2), IC3.2 (GND1_1), IC3.8 (GND1_2), J1.4, J1.MH1, J1.MH2
GND_B: C6.2, C7.2, C8.2, C9.2, IC2.9 (GNDISO_1), IC2.15 (GNDISO_2), IC3.9 (GND2_1), IC3.15 (GND2_2), IC4.2 (VN), J2.4, J2.MH1, J2.MH2
unnamed: D1.2, R10.2
unnamed: IC3.12 (PIN), R5.2
VISO: C6.1, C7.1, C8.1, C9.1, IC2.10 (VISO_1), IC2.11 (NC_2), IC2.13 (VSEL), IC2.16 (VISO_2), IC3.13 (SPD), IC3.14 (VDD2), IC3.16 (VBUS2), IC4.5 (VP), J2.1, R5.1

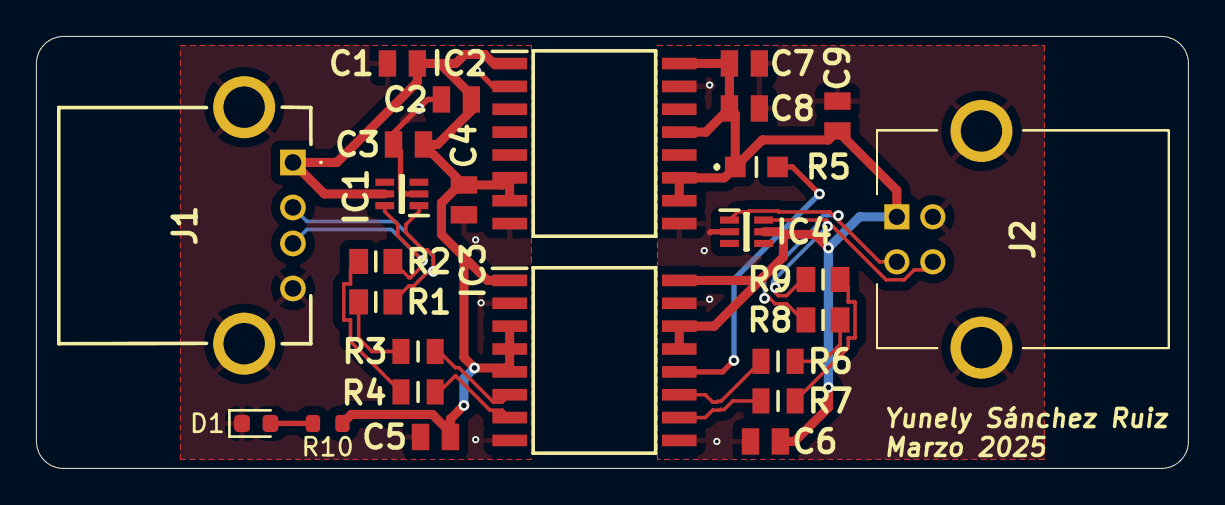
[picture p16: board Tarea_2_Aislador_USB.kicad_pcb from above]

Board: 2 copper layers, 64.0 x 24.0 mm, 26 parts (0 on the bottom side), 18 nets.
