YunelySR/Yunely_Sanchez_Electiva_2025_C1/(commit log)

2025-01-23 Esquemático listo
    [Tarea_1_Modulo_NRF24L01.kicad_pcb, Tarea_1_Modulo_NRF24L01.kicad_sch]
2025-01-23 PCB completado
    [Tarea_1_Modulo_NRF24L01.kicad_pcb, Tarea_1_Modulo_NRF24L01.kicad_sch]
2025-01-30 Resúmenes de los capítulos 1 y 2 del libro
2025-02-05 Notas clase 2 y 3 y selección de componentes
    [Librería de componentes.xlsx]
2025-02-05 modificación de la lista de componentes
    [Librería de componentes.xlsx]
2025-02-09 Apuntes clase 4
    [Librería de componentes.xlsx]
2025-02-13 Actualización de la librería de componentes: bobinas y transistores completos
    [Librería de componentes.xlsx]
2025-02-28 Clase 5 y 6 y actualización de la librería de componentes
    [Librería de componentes.xlsx]
2025-03-05 Esquemático de la tarea 2 listo
    [Librería de componentes.xlsx, Tarea_2_Aislador_USB.kicad_pcb, Tarea_2_Aislador_USB.kicad_sch]
2025-03-05 PCB de la tarea 2 finalizado
    [Tarea_2_Aislador_USB.kicad_pcb, Tarea_2_Aislador_USB.kicad_sch]
2025-03-10 Actualización del aislador USB
    [Librería de componentes.xlsx, Tarea_2_Aislador_USB.kicad_pcb, Tarea_2_Aislador_USB.kicad_sch]
2025-03-21 Librería de componentes y archivo de requisitos del proyecto
    [Librería de componentes.xlsx, Lista_de_materiales.csv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]
2025-04-21 Carcasa hecha en FreeCAD
    [Ensamble.FCStd, Parte inferior.FCStd, Parte superior.FCStd]
2025-04-25 Diseño de la carcasa en Solid Edge
    [Ensamble.cfg]
2025-04-25 Apuntes de la clase 10
